giuliagromano/Water_Tanks_Network_Control_System/media/valuesweigcons3nodes.png

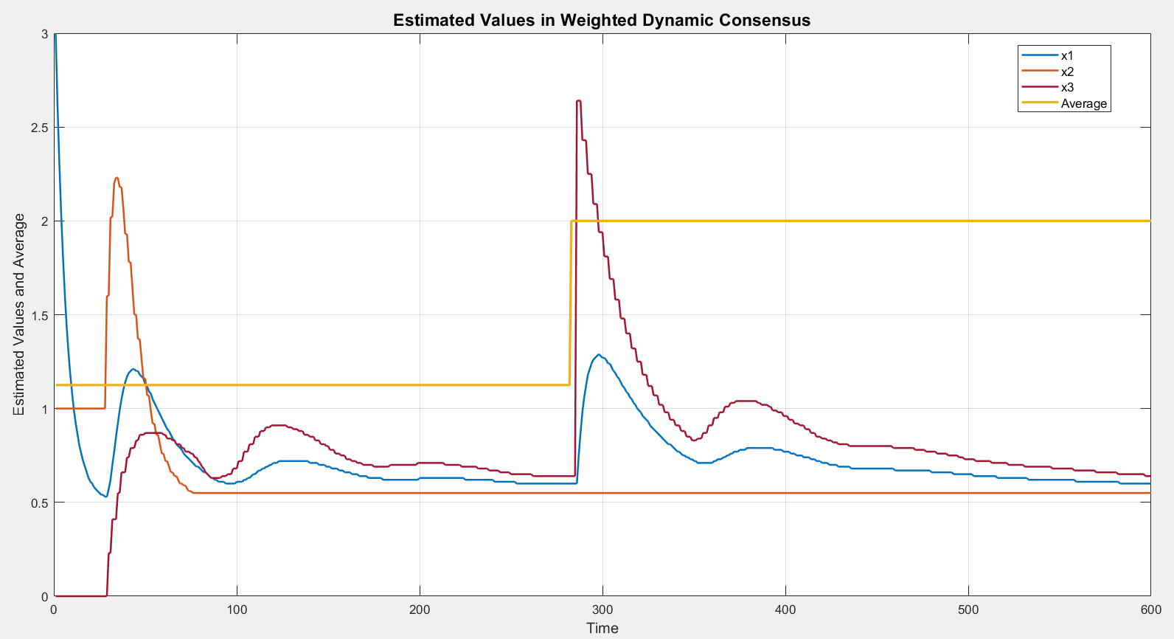
media/valuesweigcons3nodes.png
