giuliagromano/Water_Tanks_Network_Control_System/Algoritms/Dynamic_Consensus_3_Nodi/Dynamic_Consensus_3_Nodi_LowerTank_Caduto/Dynamic_Consensus_3_Nodi_LowerTank_Caduto.ino

#include <WiFi101.h>
#include <WiFiUdp.h>
#include <stdlib.h>
#include "secret2.h"

int resval;         // holds the value
int livello;        // valore in fascia del sensore
float x1 = 0, x2 = 0;     //stime dei 3 serbatoi 
int z = 0, z_pre = 0;
float epsilon = 0.4; // 1/max (di);

const int maxValues = 200; 
float x2_vet[maxValues] = {0.0};
int z_vet[maxValues] = {0};
int i = 0;          // Vector index

int counter = 0;    // Counter for consensus
int counter2 = 0;   // Loop Counter 

int respin = A0;                     // sensor pin used
const int pumpPin = 7;              // Pin digitale per controllare la pompa

bool ricevuto = false, ricevuto2 = false;

// Credenziali WiFi
// char ssid[] = "Iphone di Silvia";           // SSID della rete WiFi di Silvia
// char pass[] = "ciauciau";                   // Password della rete WiFi di Silvia

char ssid[] = "Giulia";           // SSID della rete WiFi di Giulia
char pass[] = "giuxxxxx";         // Password della rete WiFi di Giulia

// Credenziali WiFi
// char ssid[] = "Redmi Note 9 Pro";           // SSID della rete WiFi
// char pass[] = "angela123";       // Password della rete WiFi

// Indirizzo IP e porta della prima pompa
IPAddress remoteIP1(192, 168, 158, 222);    // Cambia con l'indirizzo IP del primo Arduino 
unsigned int remotePort1 = 8888;        // Porta su cui ascolta il primo Arduino

/* // Indirizzo IP e porta della seconda pompa
IPAddress remoteIP3(192, 168, 194, 189);    // Cambia con l'indirizzo IP del secondo Arduino 
unsigned int remotePort3 = 8888;            // Porta su cui ascolta il secondo Arduino
*/

WiFiUDP Udp;
unsigned int localPort = 8889;         // Porta su cui ascolta questo Arduino

void setup() {
  Serial.begin(9600);
  while (!Serial) {
    ; // Attende che la porta seriale sia connessa
  }

  // Connessione alla rete WiFi
  WiFi.begin(ssid, pass);
  while (WiFi.status() != WL_CONNECTED) {
    delay(500);
    Serial.print(".");
  }
  Serial.println("Connesso al WiFi");

  Udp.begin(localPort);
  
  // Inizializza il pin della pompa come output
  pinMode(pumpPin, OUTPUT);
  digitalWrite(pumpPin, LOW); // Assicura che la pompa sia spenta all'inizio

  // Leggo il primo valore 
  resval = analogRead(respin);    //Read data from analog pin and store it to resval variable

  if (resval <= Low2) {
    Serial.println("Water Level of this Tank: Empty");
    livello = 0;
  }
  else if (resval > Low2 && resval <= Medium2) {
    Serial.println("Water Level of this Tank: Low");
    livello = 1;
  }
  else if (resval > Medium2 && resval <= High2) {
    Serial.println("Water Level of this Tank: Medium");
    livello = 2;
  }
  else if (resval > High2) {
    Serial.println("Water Level of this Tank: High");
    livello = 3;
  }
  z = livello;
  x2 = z;

  while (ricevuto == false) {
    Udp.beginPacket(remoteIP1, remotePort1);
    Udp.print(x2);
    Udp.endPacket();

    char packetBuffer[255]; // Buffer per memorizzare i pacchetti ricevuti
    int packetSize = Udp.parsePacket();
    if (packetSize) {
      int len = Udp.read(packetBuffer, 255);
      ricevuto = true;
      if (len > 0) {
        packetBuffer[len] = 0; // Termina la stringa con un carattere nullo
      }
      x1 = atof(packetBuffer);
      Serial.print("Stima di Arduino 1: ");
      Serial.println(x1);
    } 
    delay(500);
  }
}

void sendZVet() {
  Udp.beginPacket(remoteIP1, remotePort1);
  for (int j = 0; j < maxValues; j++) {
    Udp.print(z_vet[j]);
    if (j < maxValues - 1) {
      Udp.print(", ");
    }
  }
  Udp.endPacket();
}

void loop() {
  z_pre = z;    //conservo dato precedente del sensore mio
  ricevuto2 = false;

  resval = analogRead(respin); //Read data from analog pin and store it to resval variable

  if (resval <= Low2) {
    Serial.println("Water Level of this Tank: Empty");
    livello = 0;
  }
  else if (resval > Low2 && resval <= Medium2) {
    Serial.println("Water Level of this Tank: Low");
    livello = 1;
  }
  else if (resval > Medium2 && resval <= High2) {
    Serial.println("Water Level of this Tank: Medium");
    livello = 2;
  }
  else if (resval > High2) {
    Serial.println("Water Level of this Tank: High");
    livello = 3;
  }

  Serial.print("Livello: ");
  Serial.println(livello);

  // quando x1 e x2 sono uguali aggiorno z del master col livello corrente
  if (abs(x2 - x1) < 0.01) {
    counter++; 
    if (counter == 10) { 
      z = livello;
      Serial.print("valore aggiornato di z:");
      Serial.println(z);
      counter = 0;
    }
  } else {
    counter = 0; 
  }

  x2_vet[i] = x2;
  z_vet[i] = z;
  i++;

  counter2++;
  Serial.print("Counter");
  Serial.println(counter2);

  // Controlla se i vettori sono pieni
  if (i == maxValues) {
    //Serial.println("Invio z_vet:");
    //sendZVet();
    Serial.println("Valori z2:");
      for (int i = 0; i < maxValues; i++) {
      Serial.print(z_vet[i]);
      if (i < maxValues - 1) {
        Serial.print(", ");
      }
    }
    i = 0;
  }
    //Algoritmo del consenso
    x2 = x2 - epsilon * (x2 - x1) + z - z_pre;

  Serial.print("Stima di Arduino 2: ");
  Serial.println(x2);

if (counter2 < 100) {       //Per simulare la caduta del nodo che dopo 100 non invia più e non riceve più
  while (ricevuto2 == false) {

      Udp.beginPacket(remoteIP1, remotePort1);
      Udp.print(x2);
      Udp.endPacket();
    }

    char packetBuffer[255]; // Buffer per memorizzare i pacchetti ricevuti
    int packetSize = Udp.parsePacket();
    if (packetSize) {
      int len = Udp.read(packetBuffer, 255);
      if (len > 0) {
        packetBuffer[len] = 0; // Termina la stringa con un carattere nullo
      }
      x1 = atof(packetBuffer);
      Serial.print("Stima di Arduino 1: ");
      Serial.println(x1);
      ricevuto2 = true;
    }
    delay(800);
  }
}

  if (livello > 1 && x2 > x1) {
    digitalWrite(pumpPin, HIGH);
    Serial.println("Pompa accesa");
  } else {
    // Spegne la pompa
    digitalWrite(pumpPin, LOW);
    Serial.println("Pompa spenta");
  }

  delay(1000);  // Attende 2 secondi
}
