giuliagromano/Water_Tanks_Network_Control_System/Algoritms/Algoritmo_Centralized/Master_con_riferimento/secret3.h

// secret3.h

#ifndef SECRET3_H
#define SECRET3_H

// Definizione delle variabili intere
const int Low3 = 50;
const int Lower_Medium3 = 70;
const int Medium3 = 95;
const int Upper_Medium3 = 110;
const int High3 = 550;

#endif // SECRET3_H
